trailhead/teensy-beats/README.md

# teensy-beats
Teensy Beats Shield

An all-in-one, made to hack step sequencer built around the Teensy platform with LiPo charging, touch TFT, encoders, buttons, and RGB leds.

Project build log and photos here:
https://hackaday.io/project/161127-teensy-beats-shield

...
