trailhead/teensy-beats/hardware/teensy_beats.kicad_pcb

## KiCad design hardware/teensy_beats.kicad_pcb (2018-10-22)

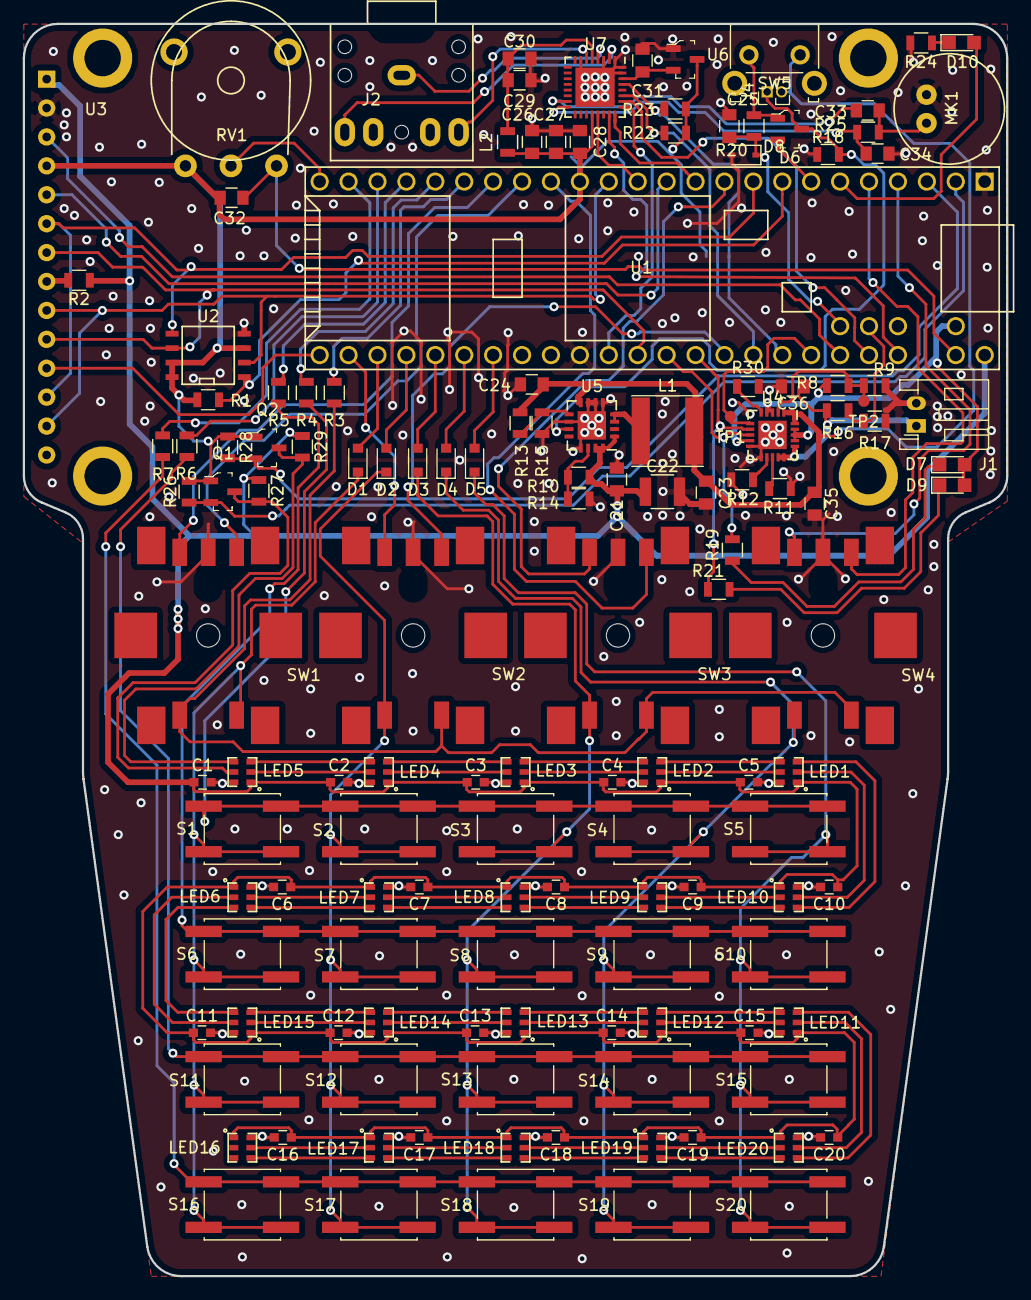
[picture p1: board teensy_beats.kicad_pcb from above]

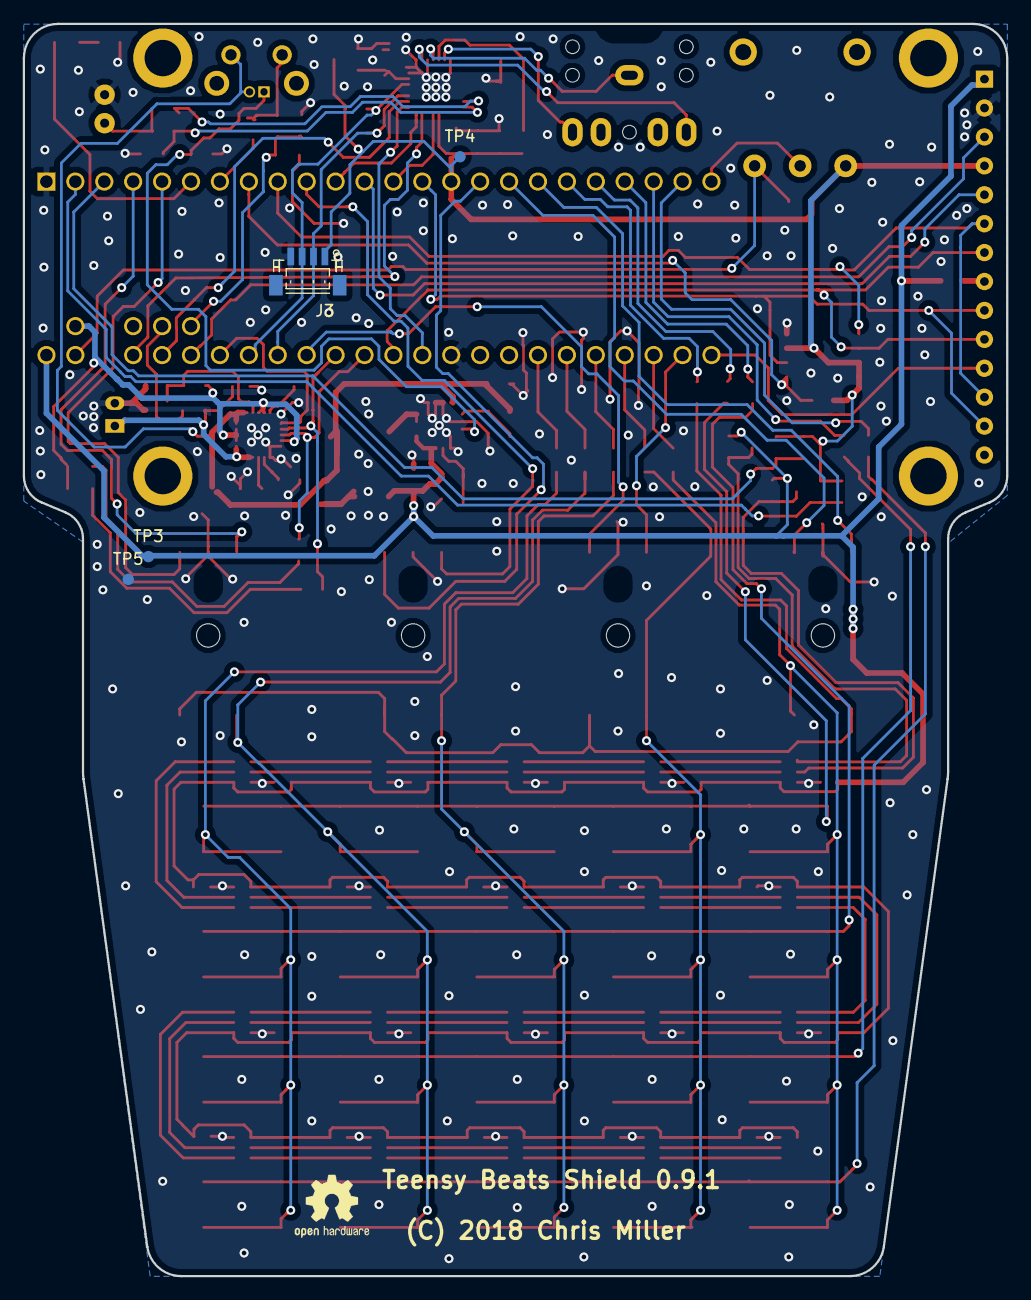
[picture p2: board teensy_beats.kicad_pcb from below]

Board: 2 copper layers, 86.4 x 110.0 mm, 143 parts (4 on the bottom side), 120 nets.

Parts:
C1, C2, C3, C4, C5, C6, C7, C8, C9, C10, C11, C12, C13, C14, C15, C16, C17, C18, C19, C20: 0.1uF; C_0603
C21, C26, C29, C31, C34: 2.2uF; C_0805
C22: 100uF; C_1210
C23, C36: 10uF; C_0805
C24, C27, C28, C30, C32, C33: 0.1uF; C_0805
C25: 1uF; C_0805
C35: 4.7uF; C_0805
D1, D2, D3, D4, D5: D; D_0805
D6: D_x2_KCom_AAK; SOT-23-3
D7, D10: STAT1; LED_0805
D8: Zener 3.3v; D_SOD-323
D9: STAT2; LED_0805
J1: Conn_01x02_Female; JST_PH_S2B-PH-K_02x2.00mm_Angled
J2: AudioJack3_Ground; SJ1-3523N
J3: Conn_01x04_Male; JST_SH_BM04B-SRSS-TB_04x1.00mm_Straight
J4: Conn_01x02_Male; Pin_Header_Straight_1x02_Pitch1.27mm
L1: L; L_Taiyo-Yuden_NR-60xx
L2: 600R; L_0805
LED1, LED2, LED3, LED4, LED5, LED6, LED7, LED8, LED9, LED10, LED11, LED12, LED13, LED14, LED15, LED16, LED17, LED18, LED19, LED20: APA102C; APA102C-2020
MK1: Microphone_Condenser; AOM-6738P-R
Q1, Q2: BSS138; SOT-23-3
R1, R16, R17, R26, R27, R28, R29, R30: 10K; R_0805
R2, R3, R4, R5, R6, R7, R19, R21, R24: 100; R_0805
R8: 270K; R_0805
R9, R12: 100K; R_0805
R10, R13: 1.87M; R_0805
R11: 1K; R_0805
R14, R18: 200K; R_0805
R15: 340K; R_0805
R20: 330; R_0805
R22, R23, R25: 2.2K; R_0805
RV1: 50K; RV100F-30-4K1-B50K
S1, S2, S3, S4, S5, S6, S7, S8, S9, S10, S11, S12, S13, S14, S15, S16, S17, S18, S19, S20: SW_Push; SW_SPST_EVQQ2
SW1, SW2, SW3, SW4: Rotary_Encoder_Switch; Bourns-SMD-Encoder
SW5: SW_Push; SW_Tactile_SKHH_Angled
TP1, TP2, TP3, TP4, TP5: TestPoint; TestPoint1mm
U1: Teensy3.6; Teensy35_36
U2: M25PX32-VMW; SOIC-8-N
U3: TFT_TOUCH_SPI; 2.4inTFT_TOUCH_SPI
U4: MCP73871; QFN-20-1EP_4x4mm_Pitch0.5mm
U5: TPS61090; QFN-16-1EP_4x4mm_Pitch0.65mm
U6: AP7313-1.8V; SOT-23-3
U7: SGTL5000; QFN-32-1EP_5x5mm_Pitch0.5mm

Connections:
+1V8: C31.1, U6.2, U7.30
+3V3: C26.1, C27.1, C28.1, C32.1, J3.1, L2.1, Q1.1, Q2.1, R1.1, R22.1, R23.1, R26.2, R28.1, RV1.1, TP4.1, U1.15, U2.3, U2.7, U2.8, U3.4, U6.3, U7.20
+5V: C1.1, C2.1, C3.1, C4.1, C5.1, C6.1, C7.1, C8.1, C9.1, C10.1, C11.1, C12.1, C13.1, C14.1, C15.1, C16.1, C17.1, C18.1, C19.1, C20.1, C21.1, C22.1, LED1.1, LED2.1, LED3.1, LED4.1, LED5.1, LED6.1, LED7.1, LED8.1, LED9.1, LED10.1, LED11.1, LED12.1, LED13.1, LED14.1, LED15.1, LED16.1, LED17.1, LED18.1, LED19.1, LED20.1, R2.1, R10.1, R27.1, R29.1, TP3.1, U1.53, U3.1, U5.1, U5.15, U5.16
+BATT: C23.1, C24.1, C35.1, J4.2, L1.2, R13.1, SW5.2, U4.1, U4.20, U5.8
AGND: C32.2, RV1.3, U1.52
BATT_LEVEL: R16.2, R17.1, U1.56
BATT_STAT1: R19.2, U1.42, U4.8
BATT_STAT2: R21.2, U1.43, U4.7
BCLK: U1.11, U7.24
CS: R1.2, U1.8, U2.1
E1A: SW1.A, U1.17
E1B: SW1.B, U1.18
E2A: SW2.A, U1.44
E2B: SW2.B, U1.31
E3A: SW3.A, U1.16
E3B: SW3.B, U1.10
E4A: SW4.A, U1.5
E4B: SW4.B, U1.4
GND: C1.2, C2.2, C3.2, C4.2, C5.2, C6.2, C7.2, C8.2, C9.2, C10.2, C11.2, C12.2, C13.2, C14.2, C15.2, C16.2, C17.2, C18.2, C19.2, C20.2, C21.2, C22.2, C23.2, C24.2, C25.2, C26.2, C27.2, C28.2, C29.2, C30.2, C31.2, C34.2, C35.2, C36.2, D8.2, J1.2, J3.4, LED1.6, LED2.6, LED3.6, LED4.6, LED5.6, LED6.6, LED7.6, LED8.6, LED9.6, LED10.6, LED11.6, LED12.6, LED13.6, LED14.6, LED15.6, LED16.6, LED17.6, LED18.6, LED19.6, LED20.6, MK1.1, R9.2, R11.2, R12.2, R14.2, R15.2, R17.2, R18.1, R24.2, R30.2, SW1.C, SW2.C, SW3.C, SW4.C, TP5.1, U1.1, U1.39, U2.4, U3.2, U4.10, U4.11, U4.21, U5.5, U5.6, U5.7, U5.10, U5.13, U5.17, U6.1, U7.1, U7.3, U7.7, U7.31, U7.32, U7.33
KEYPAD_C0: D1.2, U1.32
KEYPAD_C1: D2.2, U1.33
KEYPAD_C2: D3.2, U1.34
KEYPAD_C3: D4.2, U1.35
KEYPAD_C4: D5.2, U1.36
KEYPAD_R0: R4.2, U1.20
KEYPAD_R1: R5.2, U1.21
KEYPAD_R2: R6.2, U1.22
KEYPAD_R3: R7.2, U1.23
KEYPAD_R4: R3.2, U1.19
LRCLK: U1.50, U7.23
MCLK: U1.13, U7.21
MISO: U1.14, U2.2, U3.9, U3.13
MOSI: U1.9, U2.5, U3.6, U3.12
unnamed: C29.1, C30.1, L2.2, U7.5
unnamed: C33.1, U7.15
unnamed: C33.2, MK1.2, R25.2
unnamed: C34.1, R25.1, U7.16
unnamed: D1.1, S1.2, S6.2, S11.2, S16.2, SW1.S1
unnamed: D2.1, S2.2, S7.2, S12.2, S17.2, SW2.S2
unnamed: D3.1, S3.2, S8.2, S13.2, S18.2, SW3.S2
unnamed: D4.1, S4.2, S9.2, S14.2, S19.2, SW4.S2
unnamed: D5.1, S5.2, S10.2, S15.2, S20.2
unnamed: D6.1, R20.1, SW5.1
unnamed: D6.3, J4.1, R18.2, U5.11
unnamed: D7.1, R19.1
unnamed: D9.1, R21.1
unnamed: D10.1, R24.1
unnamed: J2.1, U7.4
unnamed: J2.2, U7.2
unnamed: J2.3, U7.6
unnamed: L1.1, U5.3, U5.4
unnamed: LED1.2, LED10.5
unnamed: LED1.3, LED10.4
unnamed: LED1.4, LED2.3
unnamed: LED1.5, LED2.2
unnamed: LED2.4, LED3.3
unnamed: LED2.5, LED3.2
unnamed: LED3.4, LED4.3
unnamed: LED3.5, LED4.2
unnamed: LED4.4, LED5.3
unnamed: LED4.5, LED5.2
unnamed: LED6.4, LED7.3
unnamed: LED6.5, LED7.2
unnamed: LED7.4, LED8.3
unnamed: LED7.5, LED8.2
unnamed: LED8.4, LED9.3
unnamed: LED8.5, LED9.2
unnamed: LED9.5, LED10.2
unnamed: LED9.4, LED10.3
unnamed: LED11.2, LED20.5
unnamed: LED11.3, LED20.4
unnamed: LED11.4, LED12.3
unnamed: LED11.5, LED12.2
unnamed: LED12.4, LED13.3
unnamed: LED12.5, LED13.2
unnamed: LED13.4, LED14.3
unnamed: LED13.5, LED14.2
unnamed: LED14.4, LED15.3
unnamed: LED14.5, LED15.2
unnamed: LED6.3, LED15.4
unnamed: LED6.2, LED15.5
unnamed: LED16.4, LED17.3
unnamed: LED16.5, LED17.2
unnamed: LED17.4, LED18.3
unnamed: LED17.5, LED18.2
unnamed: LED18.4, LED19.3
unnamed: LED18.5, LED19.2
unnamed: LED19.4, LED20.3
unnamed: LED19.5, LED20.2
unnamed: R2.2, U3.8
unnamed: R3.1, SW1.S2, SW2.S1, SW3.S1, SW4.S1
unnamed: R4.1, S1.1, S2.1, S3.1, S4.1, S5.1
unnamed: R5.1, S6.1, S7.1, S8.1, S9.1, S10.1
unnamed: R6.1, S11.1, S12.1, S13.1, S14.1, S15.1
unnamed: R7.1, S16.1, S17.1, S18.1, S19.1, S20.1
unnamed: R10.2, R14.1, U5.14
unnamed: R11.1, U4.13
unnamed: R12.1, U4.12
unnamed: R13.2, R15.1, U5.9
unnamed: R30.1, U4.5
PCTL: D6.2, U1.7
PG: TP1.1, U1.47, U4.6
PWR_BTN: C25.1, D8.1, R20.2, U1.57
REC_LED: D10.2, U1.6
RGB_CLOCK: Q1.2, R26.1, U1.2
RGB_CLOCK_HIGH: LED5.5, Q1.3, R27.2
RGB_DATA: Q2.2, R28.2, U1.3
RGB_DATA_HIGH: LED5.4, Q2.3, R29.2
RX: U1.40, U7.25
SCL: J3.3, R23.2, U1.46, U7.29
SCLK: U1.41, U2.6, U3.7, U3.10
SDA: J3.2, R22.2, U1.45, U7.27
TFT_CS: U1.48, U3.3
TFT_DC: U1.12, U3.5
TOUCH_CS: U1.30, U3.11
TX: U1.49, U7.26
VBUS: D7.2, D9.2, R8.1, U1.54, U4.3, U4.4, U4.9, U4.17, U4.18, U4.19
VLIPO: C36.1, J1.1, R16.1, U4.14, U4.15, U4.16
VOLUME: RV1.2, U1.24
VPCC: R8.2, R9.1, TP2.1, U4.2
