trailhead/teensy-beats/firmware-tests/touch_TFT_test/touch_TFT_test.ino

#include <ILI9341_t3.h>
#include <font_Arial.h> // from ILI9341_t3
#include <XPT2046_Touchscreen.h>
#include <SPI.h>

#define TOUCH_CS    33
// For optimized ILI9341_t3 library
#define TFT_DC      20
#define TFT_CS      21
#define TFT_RST    255  // 255 = unused, connect to 3.3V
#define TFT_MOSI     7
#define TFT_SCLK    14
#define TFT_MISO    12
// MOSI=11, MISO=12, SCK=13

XPT2046_Touchscreen ts(TOUCH_CS);
#define TIRQ_PIN  2
//XPT2046_Touchscreen ts(CS_PIN);  // Param 2 - NULL - No interrupts
//XPT2046_Touchscreen ts(CS_PIN, 255);  // Param 2 - 255 - No interrupts
//XPT2046_Touchscreen ts(CS_PIN, TIRQ_PIN);  // Param 2 - Touch IRQ Pin - interrupt enabled polling

ILI9341_t3 tft = ILI9341_t3(TFT_CS, TFT_DC, TFT_RST, TFT_MOSI, TFT_SCLK, TFT_MISO);

void setup() {
  Serial.begin(115200);
  tft.begin();
  tft.setRotation(3);
  tft.fillScreen(ILI9341_BLACK);
  ts.begin();
  ts.setRotation(3);
  while (!Serial && (millis() <= 1000));
}

boolean wastouched = true;

void loop() {
  boolean istouched = ts.touched();
  if (istouched) {
    TS_Point p = ts.getPoint();
    if (!wastouched) {
      tft.fillScreen(ILI9341_BLACK);
      tft.setTextColor(ILI9341_YELLOW);
      tft.setFont(Arial_60);
      tft.setCursor(60, 80);
      tft.print("Touch");
    }
    p.x = map(p.x, 290, 3700, 320, 0);
    p.y = map(p.y, 480, 3700, 240, 0);
    tft.fillRect(100, 150, 140, 60, ILI9341_BLACK);
    tft.setTextColor(ILI9341_GREEN);
    tft.setFont(Arial_24);
    tft.setCursor(100, 150);
    tft.print("X = ");
    tft.print(p.x);
    tft.setCursor(100, 180);
    tft.print("Y = ");
    tft.print(p.y);
    Serial.print(", x = ");
    Serial.print(p.x);
    Serial.print(", y = ");
    Serial.println(p.y);
  } else {
    if (wastouched) {
      tft.fillScreen(ILI9341_BLACK);
      tft.setTextColor(ILI9341_RED);
      tft.setFont(Arial_48);
      tft.setCursor(120, 50);
      tft.print("No");
      tft.setCursor(80, 120);
      tft.print("Touch");
    }
    Serial.println("no touch");
  }
  wastouched = istouched;
  delay(100);
}
