trailhead/teensy-beats/(commit log)

2018-09-16 aaddign files
    [Open Op.kicad_pcb, Open Op.sch, SGTL5000.sch, boost_and_charge.sch, keypad.sch]
2018-09-17 trying pins 0 and 1 for apa102
    [Open Op.kicad_pcb, Open Op.sch]
2018-09-17 ordered 0.9.0
    [Open Op.kicad_pcb]
2018-09-17 mass rename
    [SGTL5000.sch, boost_and_charge.sch, keypad.sch, teensy_beats.kicad_pcb, teensy_beats.sch]
2018-09-17 updating bom
2018-09-17 rearranged dirs
    [SGTL5000.sch, boost_and_charge.sch, keypad.sch, teensy_beats.kicad_pcb, teensy_beats.sch]
2018-09-22 screen navigation working, callbacks on buttons, fixed battery charging indicator
    [beats.h, screen.ino, ui_item.cpp, ui_item.h]
2018-09-28 reworking audio setup for banks
    [beats.h, instrument.h]
2018-09-29 fixing incorrect PWR_BUTTON net on schematic and PCB
    [SGTL5000.sch, boost_and_charge.sch, keypad.sch, teensy_beats.kicad_pcb]
2018-10-17 changed pin mapping to add pg signal, added enable jumper for development. adding updated gerbers.
    [boost_and_charge.sch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]
2018-10-22 moving bom into github pages directory
    [teensy_beats-B.Cu.gbr, teensy_beats-B.Mask.gbr, teensy_beats-B.Paste.gbr, teensy_beats-B.SilkS.gbr, teensy_beats-Edge.Cuts.gbr, teensy_beats-F.Cu.gbr, teensy_beats-F.Mask.gbr, teensy_beats-F.Paste.gbr]
2018-10-30 adding board outline svg files
2018-10-30 fixed battery voltage pin for 0.9.0 PCB
    [beats.h]
2019-01-05 pin changes in firmware for 0.9.1
