trailhead/teensy-beats/(notices)

Notices in the files:
Open Op.kicad_pcb:
(C) 2018 Chris Miller
